sialboat/product-design-sound-controller/README.md

# product-design-sound-controller
GitHub repository for my F25 Product Design project which aims to create a game controller that interfaces with MIDI-CC, CV, MPE, and as a Keyboard/Xbox Controller (so you can sound deisgn whilst playing games, of course)
