sialboat/product-design-sound-controller/fabrication/prod-design-sound-controller/prod-design-sound-controller.kicad_pcb

## KiCad design fabrication/prod-design-sound-controller/prod-design-sound-controller.kicad_pcb (2025-11-11)

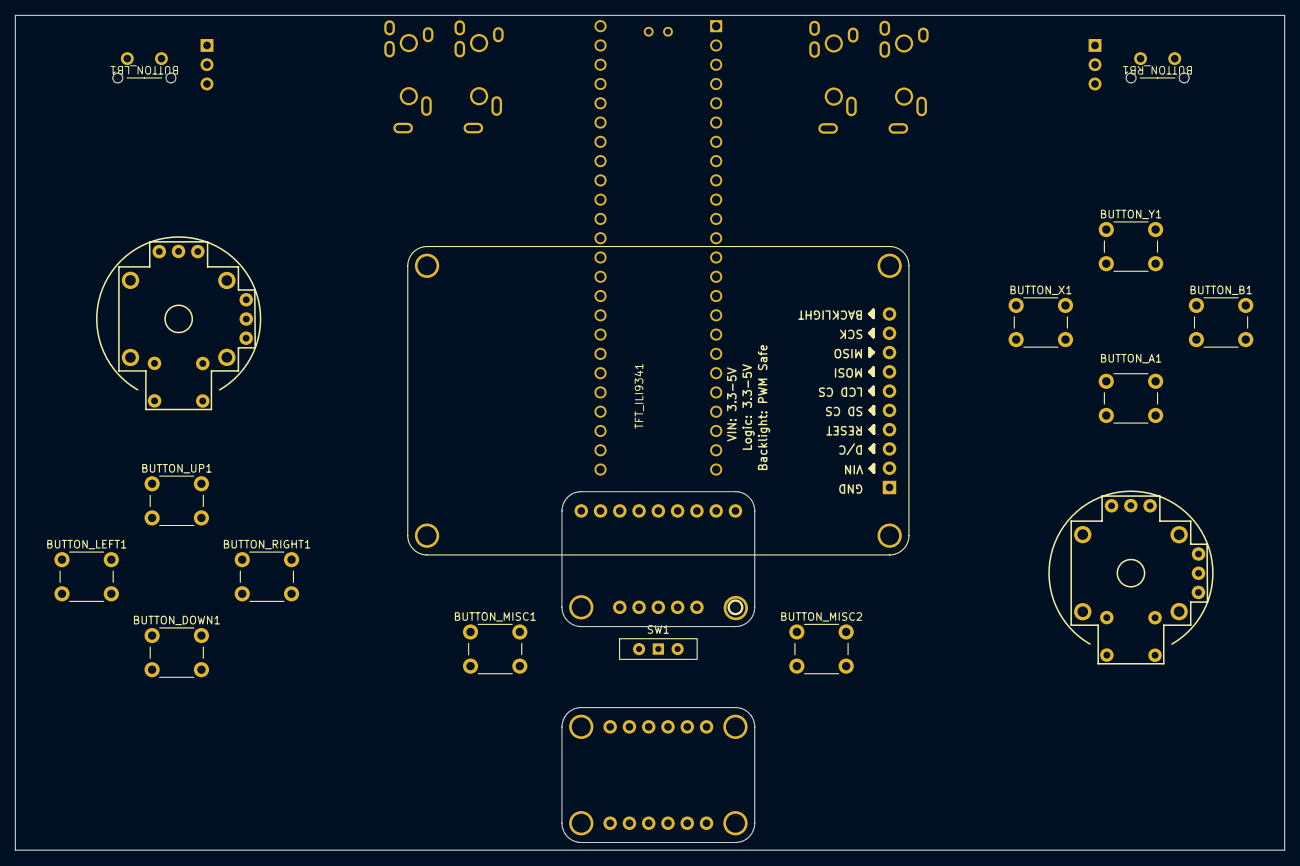
[picture p14: board prod-design-sound-controller.kicad_pcb from above]

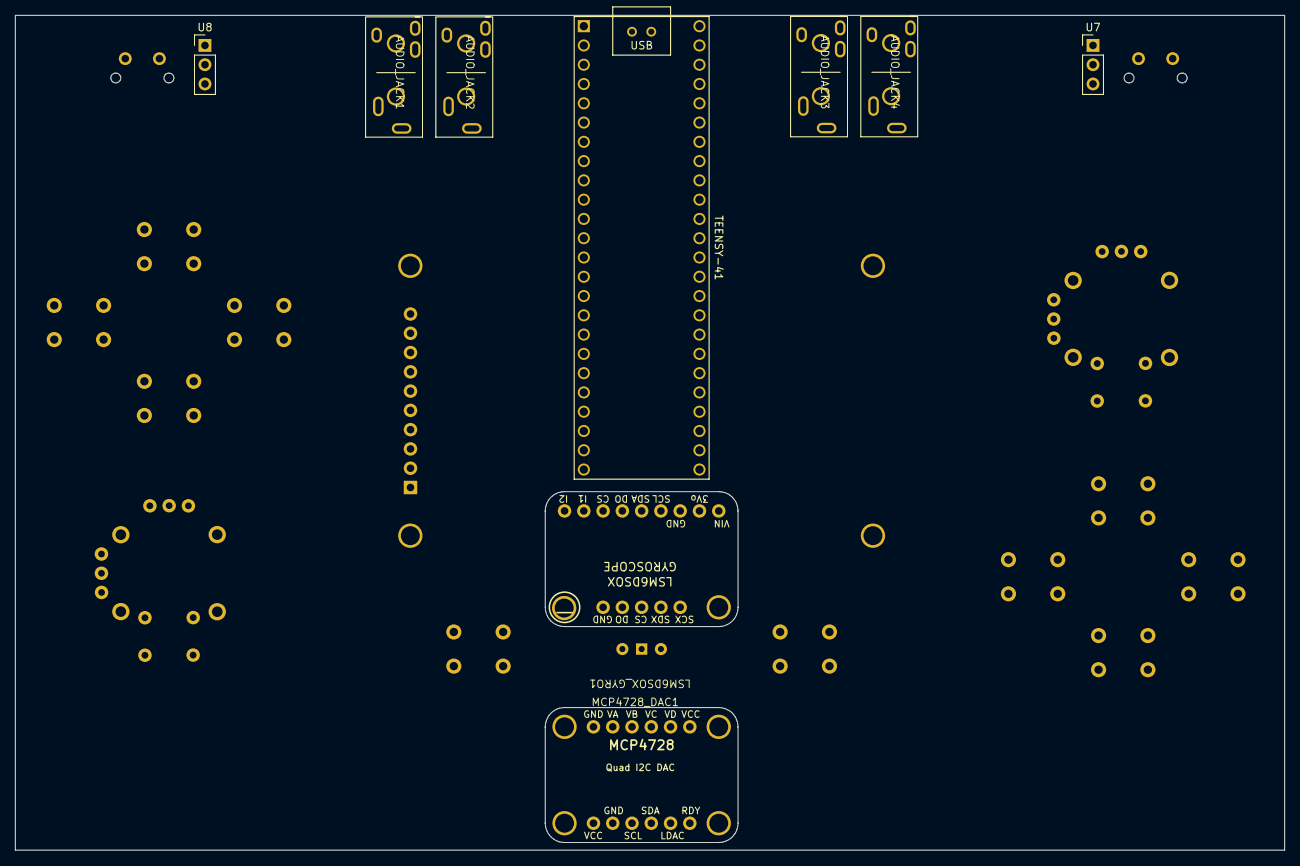
[picture p15: board prod-design-sound-controller.kicad_pcb from below]

Board: 2 copper layers, 167.2 x 110.0 mm, 25 parts (9 on the bottom side), 35 nets, no tracks yet.

Parts:
AUDIO_JACK1: CV_OUT_1; Audio_Jack
AUDIO_JACK2: CV_OUT_2; Audio_Jack
AUDIO_JACK3: CV_OUT_3; Audio_Jack
AUDIO_JACK4: CV_OUT_4; Audio_Jack
BUTTON_A1: SW_Push; SW_PUSH_6mm
BUTTON_B1: SW_Push; SW_PUSH_6mm
BUTTON_DOWN1: SW_Push; SW_PUSH_6mm
BUTTON_LB1: SW_Push; KIYOKOS-90Button
BUTTON_LEFT1: SW_Push; SW_PUSH_6mm
BUTTON_MISC1, BUTTON_MISC2: SW_Push; SW_PUSH_6mm
BUTTON_RB1: SW_Push; KIYOKOS-90Button
BUTTON_RIGHT1: SW_Push; SW_PUSH_6mm
BUTTON_UP1: SW_Push; SW_PUSH_6mm
BUTTON_X1: SW_Push; SW_PUSH_6mm
BUTTON_Y1: SW_Push; SW_PUSH_6mm
LEFT_JOYSTICK1: PS4_joystick
LSM6DSOX_GYRO1: LSM6DSOX_GYRO
MCP4728_DAC1: MCP4728_DAC
RIGHT_JOYSTICK1: PS4_joystick
SW1: BYPASS-SWITCH; SW_Slide-03_Wuerth-WS-SLTV_10x2.5x6.4_P2.54mm
TEENSY-41: Teensy4.1; Teensy41-prod-design
TFT_ILI9341: ILI9341_TFT_DISPLAY
U7: LEFT-TRIGGER; PinHeader_1x03_P2.54mm_Vertical
U8: RIGHT-TRIGGER; PinHeader_1x03_P2.54mm_Vertical

Connections:
+3.3V: LEFT_JOYSTICK1.H3 (VCC), LEFT_JOYSTICK1.V3 (VCC), LSM6DSOX_GYRO1.1 (VCC), MCP4728_DAC1.1 (VCC), RIGHT_JOYSTICK1.H3 (VCC), RIGHT_JOYSTICK1.V3 (VCC), TEENSY-41.48 (VIN), TFT_ILI9341.2 (VCC)
BUTTON-A: BUTTON_A1.2, TEENSY-41.18 (26_A12_MOSI1)
BUTTON-B: BUTTON_B1.2, TEENSY-41.17 (25_A11_RX6_SDA2)
BUTTON-DOWN: BUTTON_DOWN1.2, TEENSY-41.23 (31_CTX3)
BUTTON-LB: BUTTON_LB1.2, TEENSY-41.9 (7_RX2_OUT1A)
BUTTON-LEFT: BUTTON_LEFT1.2, TEENSY-41.22 (30_CRX3)
BUTTON-MISC1: BUTTON_MISC1.2, TEENSY-41.10 (8_TX2_IN1)
BUTTON-MISC2: BUTTON_MISC2.2, TEENSY-41.11 (9_OUT1C)
BUTTON-RB: BUTTON_RB1.2, TEENSY-41.8 (6_OUT1D)
BUTTON-RIGHT: BUTTON_RIGHT1.2, TEENSY-41.21 (29_TX7)
BUTTON-UP: BUTTON_UP1.2, TEENSY-41.24 (32_OUT1B)
BUTTON-X: BUTTON_X1.2, TEENSY-41.20 (28_RX7)
BUTTON-Y: BUTTON_Y1.2, TEENSY-41.19 (27_A13_SCK1)
BYPASS-SWITCH: SW1.2 (B), TEENSY-41.3 (1_TX1_CTX2_MISO1)
CV-1: AUDIO_JACK1.T (TIP), MCP4728_DAC1.8 (VA)
CV-2: AUDIO_JACK2.T (TIP), MCP4728_DAC1.9 (VB)
CV-3: AUDIO_JACK3.T (TIP), MCP4728_DAC1.10 (VC)
CV-4: AUDIO_JACK4.T (TIP), MCP4728_DAC1.11 (VD)
GND: AUDIO_JACK1.S (SLEEVE), AUDIO_JACK2.S (SLEEVE), AUDIO_JACK3.S (SLEEVE), AUDIO_JACK4.S (SLEEVE), BUTTON_A1.1, BUTTON_B1.1, BUTTON_DOWN1.1, BUTTON_LB1.1, BUTTON_LEFT1.1, BUTTON_MISC1.1, BUTTON_MISC2.1, BUTTON_RB1.1, BUTTON_RIGHT1.1, BUTTON_UP1.1, BUTTON_X1.1, BUTTON_Y1.1, LEFT_JOYSTICK1.B2A (GND), LEFT_JOYSTICK1.G (GND-SHIELD), LEFT_JOYSTICK1.H1 (GND), LEFT_JOYSTICK1.V1 (GND), LSM6DSOX_GYRO1.3 (GND), MCP4728_DAC1.2 (GND), RIGHT_JOYSTICK1.B2A (GND), RIGHT_JOYSTICK1.G (GND-SHIELD), RIGHT_JOYSTICK1.H1 (GND), RIGHT_JOYSTICK1.V1 (GND), SW1.1 (A), TEENSY-41.1 (GND), TEENSY-41.47 (GND), TFT_ILI9341.1 (GND)
ILI9341-DISPLAY-CS: TEENSY-41.12 (10_CS_MQSR), TFT_ILI9341.6 (CS)
ILI9341-DISPLAY-DC: TEENSY-41.26 (34_RX8), TFT_ILI9341.3 (DC)
ILI9341-DISPLAY-MISO: TEENSY-41.14 (12_MISO_MQSL), TFT_ILI9341.8 (MISO)
ILI9341-DISPLAY-MOSI: TEENSY-41.13 (11_MOSI_CTX1), TFT_ILI9341.7 (MOSI)
ILI9341-DISPLAY-RST: TEENSY-41.25 (33_MCLK2), TFT_ILI9341.4 (RST)
ILI9341-DISPLAY-SCK: TEENSY-41.35 (13_SCK_LED), TFT_ILI9341.9 (SCK)
INTERRUPT-1: LSM6DSOX_GYRO1.8 (I1), TEENSY-41.28 (36_CS)
INTERRUPT-2: LSM6DSOX_GYRO1.9 (I2), TEENSY-41.29 (37_CS)
LEFT-JOY-SEL: LEFT_JOYSTICK1.B1A (SEL), TEENSY-41.4 (2_OUT2)
LEFT-JOY-X: LEFT_JOYSTICK1.H2 (XOUT), TEENSY-41.42 (20_A6_TX5_LRCLK1)
LEFT-JOY-Y: LEFT_JOYSTICK1.V2 (YOUT), TEENSY-41.43 (21_A7_RX5_BCLK1)
RIGHT-JOY-SEL: RIGHT_JOYSTICK1.B1A (SEL), TEENSY-41.5 (3_LRCLK2)
RIGHT-JOY-X: RIGHT_JOYSTICK1.H2 (XOUT), TEENSY-41.44 (22_A8_CTX1)
RIGHT-JOY-Y: RIGHT_JOYSTICK1.V2 (YOUT), TEENSY-41.45 (23_A9_CRX1_MCLK1)
WIRE1-SCL: LSM6DSOX_GYRO1.4 (SCL), MCP4728_DAC1.3 (SCL), TEENSY-41.41 (19_A5_SCL)
WIRE1-SDA: LSM6DSOX_GYRO1.5 (SDA), MCP4728_DAC1.4 (SDA), TEENSY-41.40 (18_A4_SDA)
