sialboat/product-design-sound-controller/midterm demo/product_design_copy_20251003015627/Menu.h

// includes that I'm too lazy to write
// #include "Arduino.h"
// #include "tgx.h"
// #include "ILI9341_T4.h"

// class MenuItem {
//   public:
//   MenuItem* items;
//   int numItems;
//   int selected;
//   Menu (MenuItem* its, int n) : items(its), numItems(n), selected(0) {}

//   // void draw(put the display here silas thanks)
//   // void next();
//   // void prev();
//   // void select();
// }
