sialboat/product-design-sound-controller/midterm demo/product_design_copy_20251003015627/MenuItem.h

// items that i'm too lazy to write

// class MenuItem {
//   public:
//   String label;
//   void (*action)();
//   Menu* submenu;
//   MenuItem(String _label, void (*a)() = nullptr, Menu* sub = nullptr) : 
//     label(_label), action(a), submenu(sub) {}
// }
