sialboat/product-design-sound-controller/midterm demo/product_design_copy_20251003015627/betterText.h

// #include <Adafruit_GFX.h>
// #include <Adafruit_ILI9341.h>

//Desired text size. 1 is default 6x8, 2 is 12x16, 3 is 18x24, etc (1 argument setTextSize)
//Set text 'magnification' size. Each increase in s makes 1 pixel that much bigger.

//Parameters
//    s_x	Desired text width magnification level in X-axis. 1 is default
//    s_y	Desired text width magnification level in Y-axis. 1 is default 
class betterText
{
public:
betterText(Adafruit_ILI9341 display);
private:
};
