sialboat/product-design-sound-controller/(commit log)

2025-08-06 06 08 25 - added the current files i have
2025-11-11 2025-11-10 push
    Pushing to github for syncing purposes
    [prod-design-sound-controller.kicad_pcb, prod-design-sound-controller.kicad_sch]
2025-11-20 revision v3 of pcb includes proper display placement. Needs additional adjustment for trigger, button, and joystick placement.
